stephan192/doorbell/pcb/BOM_PCB_doorbell_2021-09-07.csv

ID | Name | Designator | Footprint | Quantity | Manufacturer Part | Manufacturer | Supplier | Supplier Part | Price
1 | BAV99,215 | D4,D5 | SOT-23-3_L2.9-W1.6-P1.90-LS2.8-BR | 2 | BAV99,215 | Nexperia | LCSC | C2500 | 0.022
2 | DB107S_C5377 | D3 | DBS_L8.4-W6.4-P5.10-LS10.2-TL | 1 | DB107S | MDD | LCSC | C5377 | 0.076
3 | SS14 | D1,D2 | SMA_L4.4-W2.8-LS5.4-RD | 2 | SS14 | MDD | LCSC | C2480 | 0.03
4 | AO3400A | Q1,Q2,Q3,Q4 | SOT-23-3_L2.9-W1.6-P1.90-LS2.8-BR | 4 | AO3400A | AOS | LCSC | C20917 | 0.252
5 | AMS1117-3.3 | U3 | SOT-223-3_L6.5-W3.4-P2.30-LS7.0-BR | 1 | AMS1117-3.3 | AMS | LCSC | C6186 | 0.147
6 | 1uF | C3 | C0805 | 1 | CL21B105KBFNNNE | SAMSUNG | LCSC | C28323 | 0.01
7 | 43K | R1 | R0805 | 1 | 0805W8F4302T5E | UniOhm | LCSC | C17695 | 0.002
8 | 10K | R2,R7,R10,R11,R12,R15,R16,R17,R18,R19,R20 | R0805 | 11 | 0805W8F1002T5E | UniOhm | LCSC | C17414 | 0.002
9 | MCP16312-E/MS | U2 | MSOP-8_L3.0-W3.0-P0.65-LS5.0-TL | 1 | MCP16312-E/MS | MICROCHIP | LCSC | C148099 | 1.41
10 | 210S-1*3P L=11.6MMGold-plated black | H1 | HDR-TH_3P-P2.54-V-M-1 | 1 | 210S-1*3P L=11.6MMGold-plated black | Ckmtw | LCSC | C124376 | 0.019
11 | 0 | R13,R14 | R1206 | 2 | 1206W4F0000T5E | UniOhm | LCSC | C17888 | 0.004
12 | 210S-1*2P L=11.6MMGold-plated black | H2,H3 | HDR-TH_2P-P2.54-V-M-1 | 2 | 210S-1*2P L=11.6MMGold-plated black | Ckmtw | LCSC | C124375 | 0.017
13 | 10uF | C1,C6,C8,C9,C13 | C1206 | 5 | CL31A106KBHNNNE | SAMSUNG | LCSC | C13585 | 0.039
14 | 100uF | C2,C7,C10 | CAP-SMD_BD10.0-L10.3-W10.3-RD | 3 | VZH101M1HTR-1010 | LELON | LCSC | C134808 | 0.202
15 | 100nF | C5,C11,C12 | C0805 | 3 | CC0805KRX7R9BB104 | YAGEO | LCSC | C49678 | 0.006
16 | PA001-4P | CN1,CN2,CN5,CN6 | CONN-TH_4P-P5.08_PA001-4P | 4 | PA001-4P | HIWA | LCSC | C173286 | 0.216
17 | 22uH | L2 | IND-SMD_L8.0-W8.0_SWPA8040S | 1 | SWPA8040S220MT | Sunlord | LCSC | C15857 | 0.102
18 | 8.2K | R6 | R0805 | 1 | 0805W8F8201T5E | UniOhm | LCSC | C17828 | 0.002
19 | 100 | R8,R9 | R0805 | 2 | 0805W8F1000T5E | UniOhm | LCSC | C17408 | 0.002
20 | JZC-32F/005-HS3(555) | RLY1,RLY2 | RELAY-TH_JZC-32F-XXXHXX | 2 | JZC-32F/005-HS3(555) | HF | LCSC | C9222 | 0.408
21 | ESP-12F(ESP8266MOD) | U1 | WIFIM-SMD_ESP-12F-ESP8266MOD | 1 | ESP-12F(ESP8266MOD) | Ai-Thinker | LCSC | C82891 | 1.475
22 | 10nF | C14,C15 | C0805 | 2 | CL21B103KBANNNC | SAMSUNG | LCSC | C1710 | 0.007
