stephan192/doorbell/pcb/Schematic_doorbell_2021-09-07.pdf

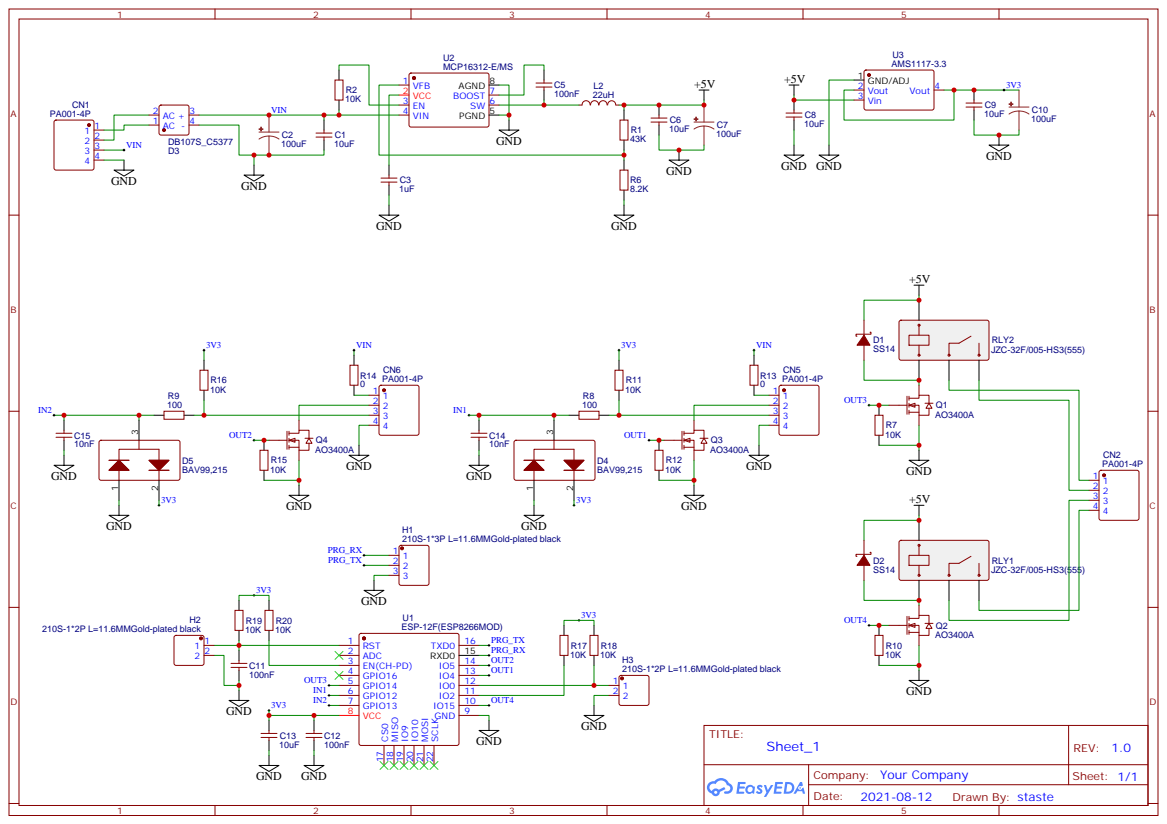
[picture p2: page 1]
