stephan192/doorbell/pcb/PCB_PCB_doorbell_2021-09-07.pdf

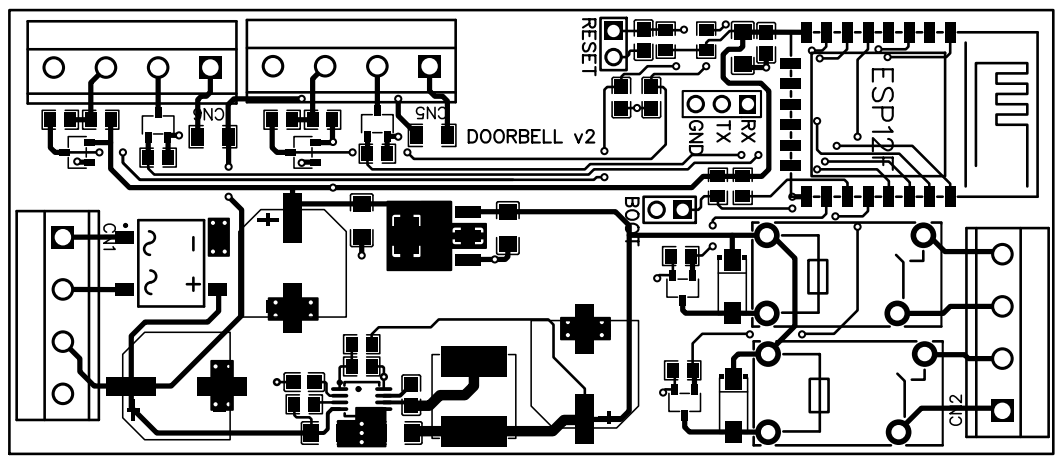
[picture p3: page 1]
