stephan192/doorbell/(list of files, drawings)

Other design files:
pcb/PCB_PCB_doorbell_2021-09-07.json
pcb/SCH_doorbell_2021-09-07.json
